jsenzel1/petrock/(threads)

Thread 2 (2024-06-07):

Update manual to make it clearer that under the New Moon B side does not output anything

nlighteneddesign, 2024-06-07:
I happened to first power on the PetRock under a new moon and it took a fair amount of confusion on why the B side would not output before I noticed the line in the manual:

```
New moon: A is emerging B is obscured
```

I first had read the Notes for use (technical) several times trying to figure out what was going wrong.
It may be helpful for future printings to include a note somewhere that explicitly states that the petrock does not output on B under the new moon.

nlighteneddesign, 2024-12-09:
PR was merged.

Closed 2024-12-09.

Thread 4 (2024-12-08):

Panel folder contains copy of mainboard files, not panel files

ryokell, 2024-12-08:
It looks like the panel folder just contains a copy of the same files as the board folder at the moment, not the panel files as expected.

jsenzel1, 2024-12-09:
hm, redownloaded and put em into kicad, looks like the panel files to me, maybe give it a once over and if its still not working I can just reupload?

ryokell, 2024-12-10:
ahh I see - apologies, the files all being named identically threw me off. It looks like they are indeed correct after all!

Closed 2024-12-10.
