jsenzel1/petrock/hardware - kiCad/board/input_protection.kicad_sch

## KiCad design hardware - kiCad/board/input_protection.kicad_sch (2023-12-20)

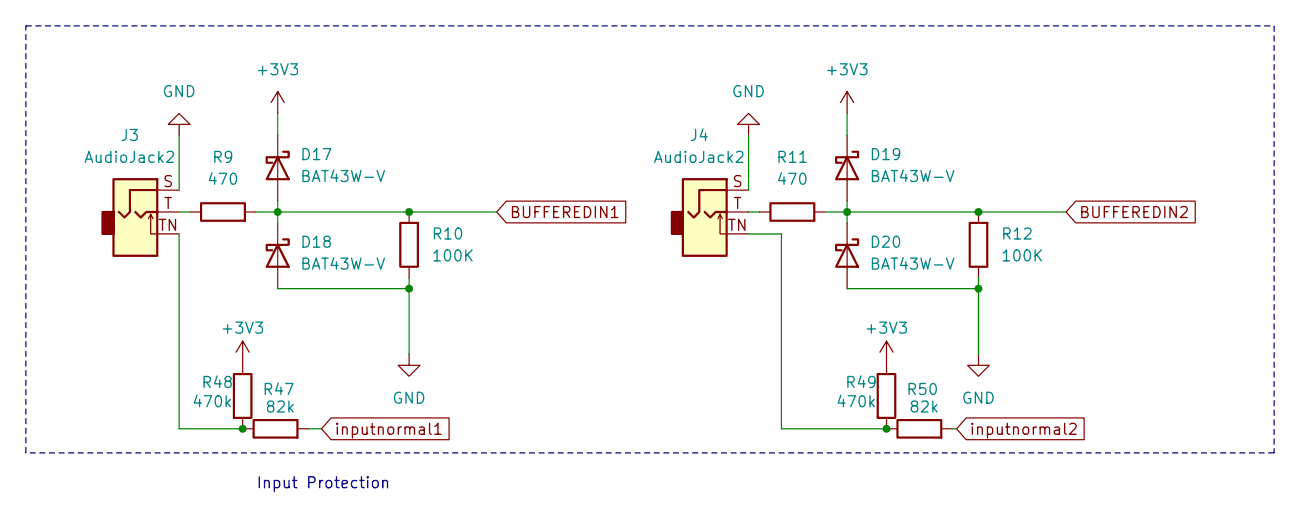
[picture p1: schematic input_protection.kicad_sch]

Parts:
D17, D18, D19, D20: BAT43W-V; D_SOD-323; JLC part Number C19167
J3, J4: AudioJack2; _Jack_3.5mm_QingPu_JACK_ANCHOR
R9, R11: 470; C_0402_1005Metric; JLC part Number C25117
R10, R12: 100K; C_0402_1005Metric; JLC part Number C25741
R47, R50: 82k; C_0402_1005Metric; LCSC C4142
R48, R49: 470k; C_0402_1005Metric; LCSC C25790

Connections:
+3V3: D17.1 (K), D19.1 (K), R48.1, R49.1
BUFFEREDIN1: D17.2 (A), D18.1 (K), R9.2, R10.2
BUFFEREDIN2: D19.2 (A), D20.1 (K), R11.2, R12.2
GND: D18.2 (A), D20.2 (A), J3.S, J4.S, R10.1, R12.1
unnamed: J3.T, R9.1
unnamed: J3.TN, R47.1, R48.2
unnamed: J4.T, R11.1
unnamed: J4.TN, R49.2, R50.1
inputnormal1: R47.2
inputnormal2: R50.2

Notes on the sheet:
Input Protection
