jsenzel1/petrock/hardware - kiCad/board/outPutLevelShift.kicad_sch

## KiCad design hardware - kiCad/board/outPutLevelShift.kicad_sch (2023-12-20)

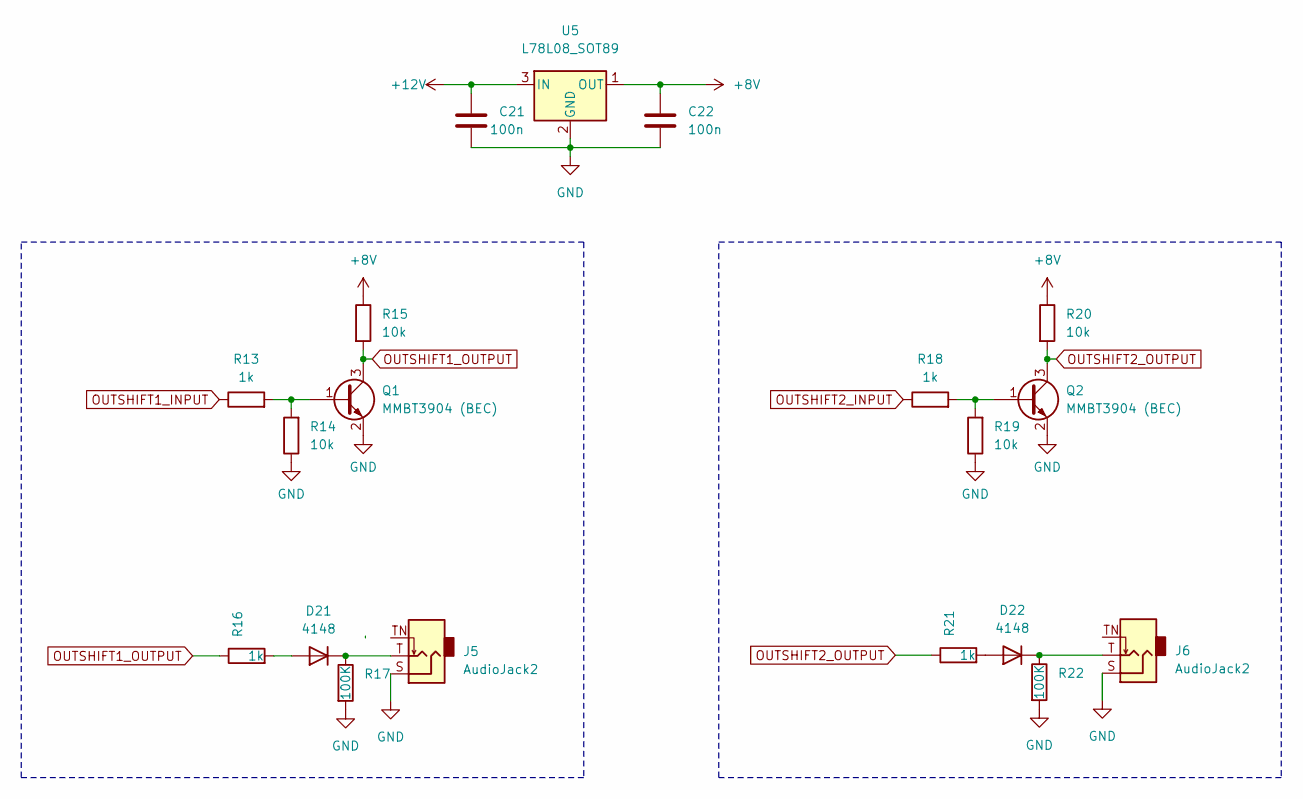
[picture p2: schematic outPutLevelShift.kicad_sch]

Parts:
C21, C22: 100n; C_0402_1005Metric; JLC part Number C1525
D21, D22: 4148; D_SOD-323; JLC part Number C81598
J5, J6: AudioJack2; _Jack_3.5mm_QingPu_JACK_ANCHOR
Q1, Q2: MMBT3904 (BEC); SOT-23; JLC part Number C20526
R13, R16, R18, R21: 1k; C_0402_1005Metric; LCSC C11702
R14, R15, R19, R20: 10k; C_0402_1005Metric; JLC part Number C25744
R17, R22: 100K; C_0402_1005Metric; JLC part Number C25741
U5: L78L08_SOT89; SOT-89-3; JLC part Number C122846

Connections:
+8V: C22.1, R15.1, R20.1, U5.1 (OUT)
+12V: C21.1, U5.3 (IN)
GND: C21.2, C22.2, J5.S, J6.S, Q1.2 (E), Q2.2 (E), R14.1, R17.2, R19.1, R22.2, U5.2 (GND)
unnamed: D21.1 (K), J5.T, R17.1
unnamed: D21.2 (A), R16.2
unnamed: D22.1 (K), J6.T, R22.1
unnamed: D22.2 (A), R21.2
unnamed: Q1.1 (B), R13.2, R14.2
unnamed: Q2.1 (B), R18.2, R19.2
OUTSHIFT1_INPUT: R13.1
OUTSHIFT1_OUTPUT: Q1.3 (C), R15.2, R16.1
OUTSHIFT2_INPUT: R18.1
OUTSHIFT2_OUTPUT: Q2.3 (C), R20.2, R21.1
