jsenzel1/petrock/hardware - kiCad/board/petRockMain1.kicad_sch

## KiCad design hardware - kiCad/board/petRockMain1.kicad_sch (2023-12-20)

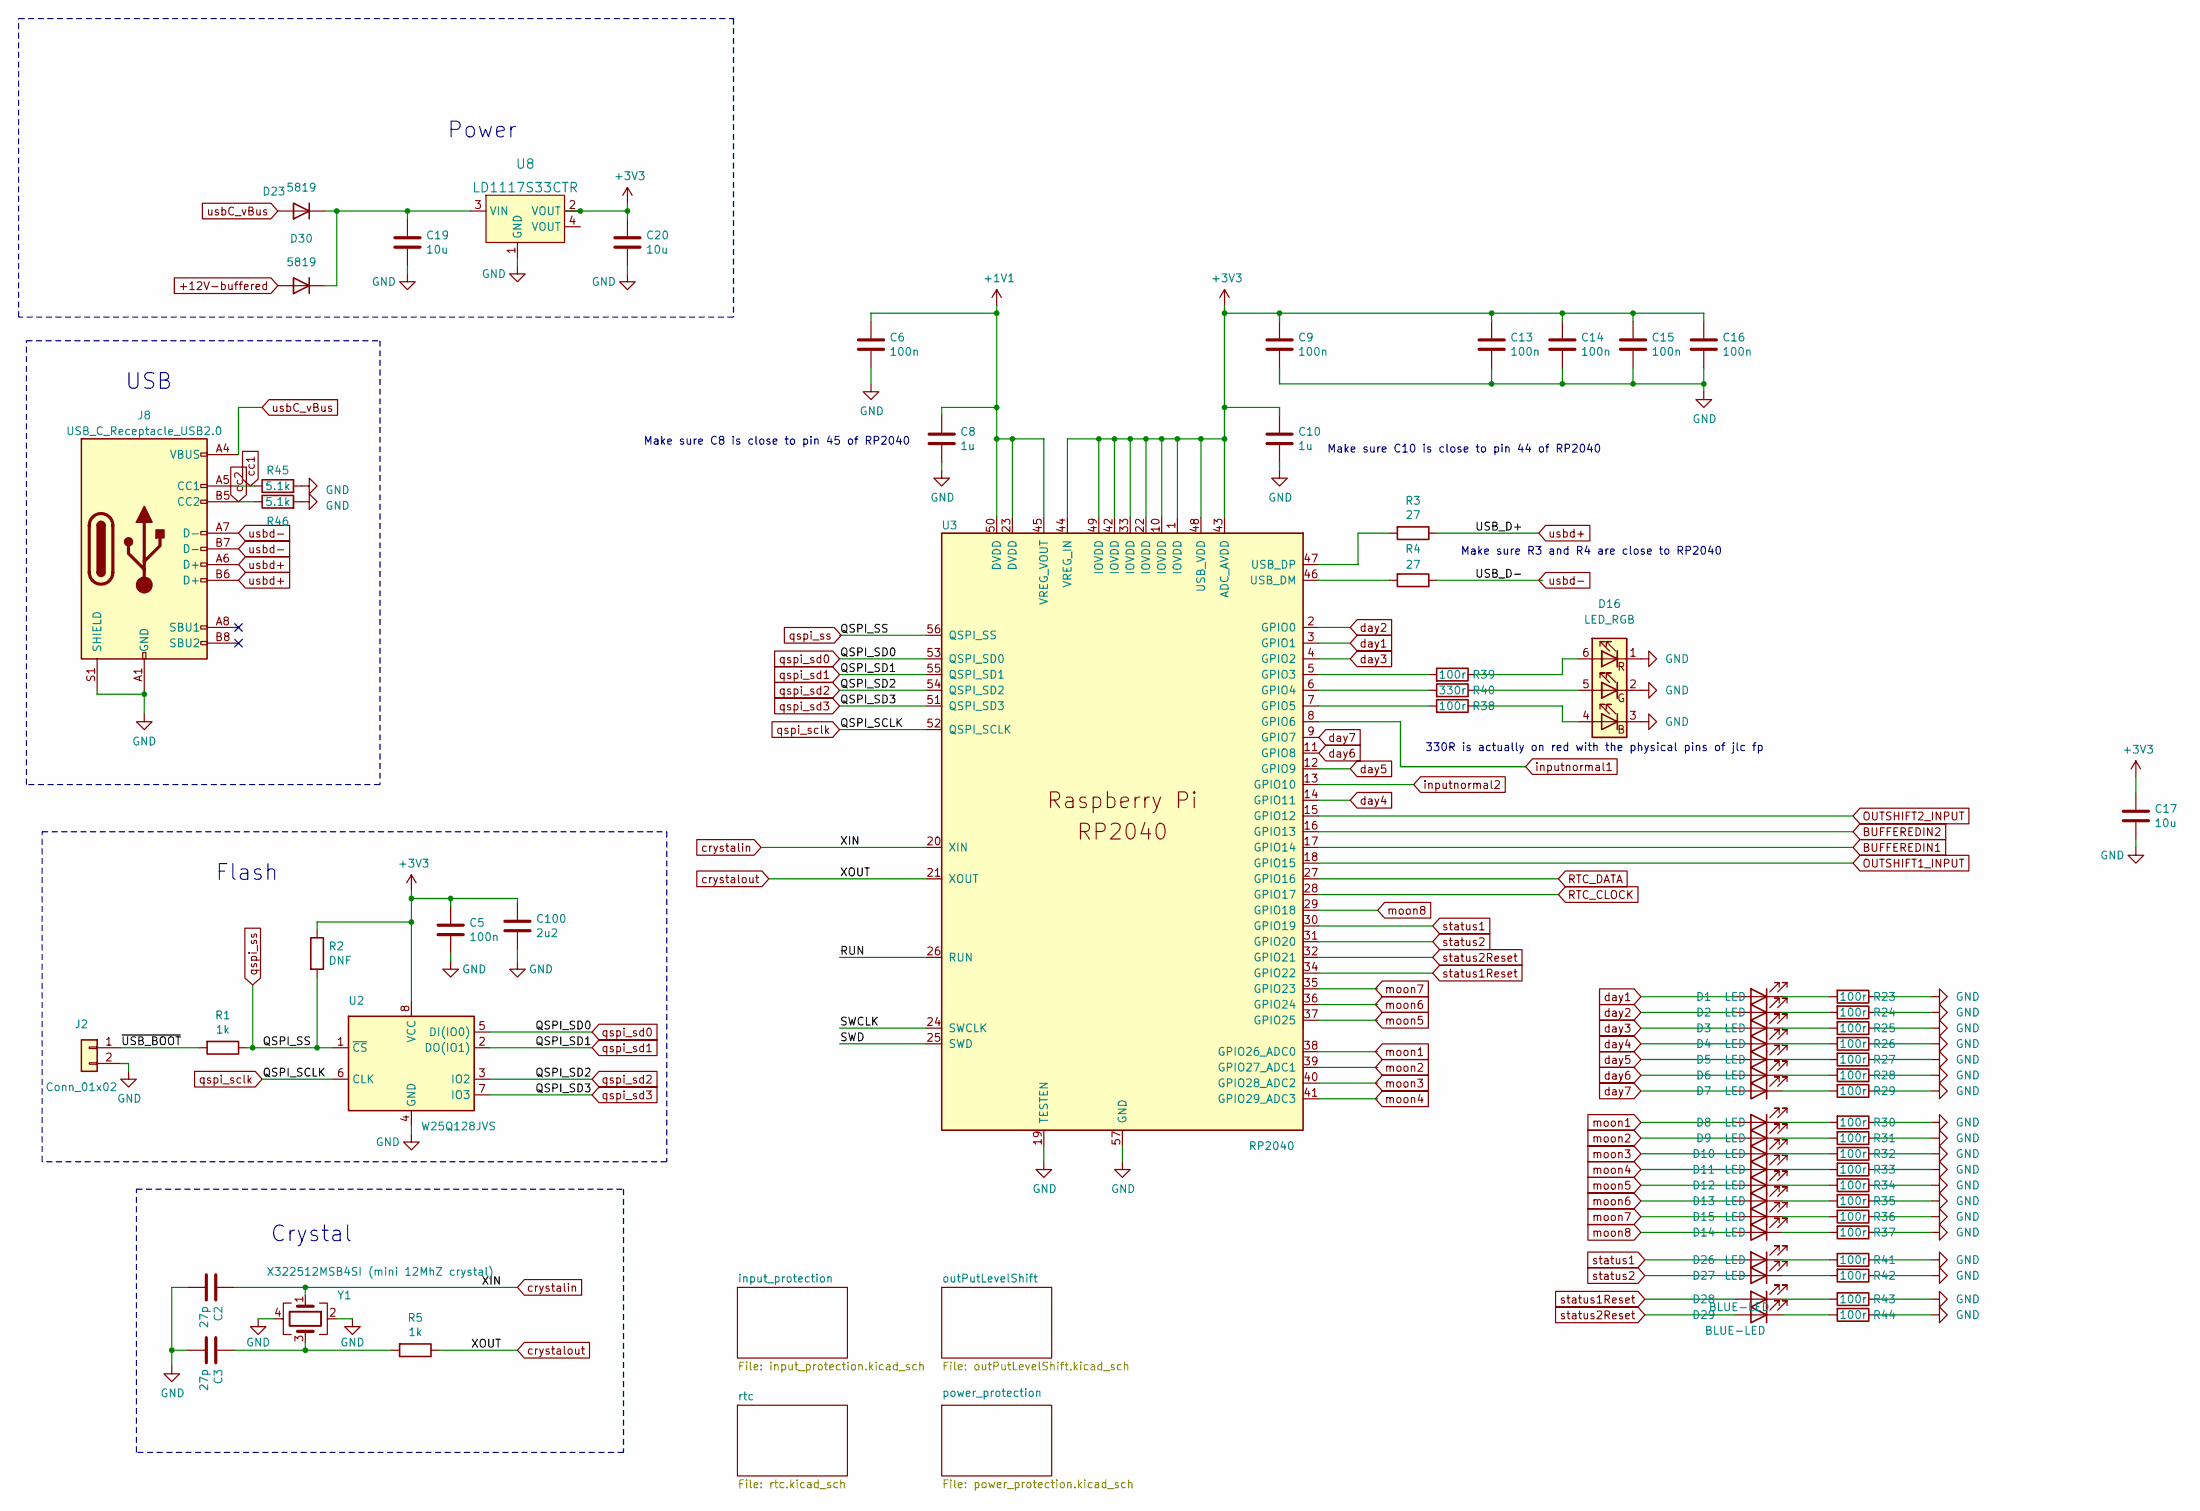
[picture p3: schematic petRockMain1.kicad_sch]

Parts:
C2, C3: 27p; C_0402_1005Metric; JLC part Number C1557
C5, C6, C9, C13, C14, C15, C16: 100n; C_0402_1005Metric; JLC part Number C1525
C8, C10: 1u; C_0402_1005Metric; JLC part Number C52923
C17, C19, C20: 10u; C_0402_1005Metric; JLC part Number C15850
C100: 2u2; C_0402_1005Metric; JLC part Number C1525
D1, D2, D3, D4, D5, D6, D7, D8, D9, D10, D11, D12, D13, D14, D15, D26, D27: LED; LED_0402_1005Metric; JLC part Number C72038
D16: LED_RGB; LED_RGB_5050-6; JLC part Number C784540
D23, D30: 5819; D_SOD-123; LCSC C8598
D28, D29: BLUE-LED; LED_0402_1005Metric; JLC part Number C72038
J2: Conn_01x02; SW_PUSH_6mm
J8: USB_C_Receptacle_USB2.0; USB_C_Receptacle_G-Switch_GT-USB-7010ASV; LCSC C2988369
R1, R5: 1k; C_0402_1005Metric; LCSC C11702
R2: DNF; C_0402_1005Metric
R3, R4: 27; C_0402_1005Metric; JLC part Number C25100
R23, R24, R25, R26, R27, R28, R29, R30, R31, R32, R33, R34, R35, R36, R37, R38, R39, R41, R42, R43, R44: 100r; C_0402_1005Metric; JLC part Number C25076
R40: 330r; C_0402_1005Metric; JLC part Number C25104
R45, R46: 5.1k; C_0402_1005Metric; LCSC C25905
U2: W25Q128JVS; SON50P300X200X60-9N; JLC part Number C97521
U3: RP2040; RP2040-QFN-56; JLC part Number C2040
U8: LD1117S33CTR; SOT-89-3; MPN LD1117S33CTR; Digi-Key_PN 497-1241-1-ND
Y1: X322512MSB4SI (mini 12MhZ crystal); Crystal_SMD_3225-4Pin_3.2x2.5mm; JLC part Number C111117

Connections:
+1V1: C6.1, C8.1, U3.23 (DVDD), U3.45 (VREG_VOUT), U3.50 (DVDD)
+3V3: C5.1, C9.1, C10.1, C13.1, C14.1, C15.1, C16.1, C17.1, C20.1, C100.1, R2.1, U2.8 (VCC), U3.1 (IOVDD), U3.10 (IOVDD), U3.22 (IOVDD), U3.33 (IOVDD), U3.42 (IOVDD), U3.43 (ADC_AVDD), U3.44 (VREG_IN), U3.48 (USB_VDD), U3.49 (IOVDD), U8.2 (VOUT)
+12V-buffered: D30.2 (A)
BUFFEREDIN1: U3.17 (GPIO14)
BUFFEREDIN2: U3.16 (GPIO13)
GND: C2.2, C3.2, C5.2, C6.2, C8.2, C9.2, C10.2, C13.2, C14.2, C15.2, C16.2, C17.2, C19.2, C20.2, C100.2, D16.1 (RK), D16.2 (GK), D16.3 (BK), J2.2, J8.A1 (GND), J8.A12 (GND), J8.B1 (GND), J8.B12 (GND), J8.S1 (SHIELD), R23.1, R24.1, R25.1, R26.1, R27.1, R28.1, R29.1, R30.1, R31.1, R32.1, R33.1, R34.1, R35.1, R36.1, R37.1, R41.1, R42.1, R43.1, R44.1, R45.2, R46.2, U2.4 (GND), U3.19 (TESTEN), U3.57 (GND), U8.1 (GND), Y1.2, Y1.4
unnamed: C3.1, R5.2, Y1.3
unnamed: C19.1, D23.1 (K), D30.1 (K), U8.3 (VIN)
unnamed: D1.1 (K), R23.2
unnamed: D2.1 (K), R24.2
unnamed: D3.1 (K), R25.2
unnamed: D4.1 (K), R26.2
unnamed: D5.1 (K), R27.2
unnamed: D6.1 (K), R28.2
unnamed: D7.1 (K), R29.2
unnamed: D8.1 (K), R30.2
unnamed: D9.1 (K), R31.2
unnamed: D10.1 (K), R32.2
unnamed: D11.1 (K), R33.2
unnamed: D12.1 (K), R34.2
unnamed: D13.1 (K), R35.2
unnamed: D14.1 (K), R37.2
unnamed: D15.1 (K), R36.2
unnamed: D16.4 (BA), R38.1
unnamed: D16.5 (GA), R40.1
unnamed: D16.6 (RA), R39.1
unnamed: D26.1 (K), R41.2
unnamed: D27.1 (K), R42.2
unnamed: D28.1 (K), R43.2
unnamed: D29.1 (K), R44.2
unnamed: R3.2, U3.47 (USB_DP)
unnamed: R4.2, U3.46 (USB_DM)
unnamed: R38.2, U3.7 (GPIO5)
unnamed: R39.2, U3.5 (GPIO3)
unnamed: R40.2, U3.6 (GPIO4)
OUTSHIFT1_INPUT: U3.18 (GPIO15)
OUTSHIFT2_INPUT: U3.15 (GPIO12)
RTC_CLOCK: U3.28 (GPIO17)
RTC_DATA: U3.27 (GPIO16)
RUN: U3.26 (RUN)
SWCLK: U3.24 (SWCLK)
SWD: U3.25 (SWD)
cc1: J8.A5 (CC1), R45.1
cc2: J8.B5 (CC2), R46.1
crystalin: C2.1, U3.20 (XIN), Y1.1
crystalout: R5.1, U3.21 (XOUT)
day1: D1.2 (A), U3.3 (GPIO1)
day2: D2.2 (A), U3.2 (GPIO0)
day3: D3.2 (A), U3.4 (GPIO2)
day4: D4.2 (A), U3.14 (GPIO11)
day5: D5.2 (A), U3.12 (GPIO9)
day6: D6.2 (A), U3.11 (GPIO8)
day7: D7.2 (A), U3.9 (GPIO7)
inputnormal1: U3.8 (GPIO6)
inputnormal2: U3.13 (GPIO10)
moon1: D8.2 (A), U3.38 (GPIO26_ADC0)
moon2: D9.2 (A), U3.39 (GPIO27_ADC1)
moon3: D10.2 (A), U3.40 (GPIO28_ADC2)
moon4: D11.2 (A), U3.41 (GPIO29_ADC3)
moon5: D12.2 (A), U3.37 (GPIO25)
moon6: D13.2 (A), U3.36 (GPIO24)
moon7: D15.2 (A), U3.35 (GPIO23)
moon8: D14.2 (A), U3.29 (GPIO18)
qspi_sclk: U2.6 (CLK), U3.52 (QSPI_SCLK)
qspi_sd0: U2.5 (DI(IO0)), U3.53 (QSPI_SD0)
qspi_sd1: U2.2 (DO(IO1)), U3.55 (QSPI_SD1)
qspi_sd2: U2.3 (IO2), U3.54 (QSPI_SD2)
qspi_sd3: U2.7 (IO3), U3.51 (QSPI_SD3)
qspi_ss: R1.1, R2.2, U2.1 (~CS), U3.56 (QSPI_SS)
status1: D26.2 (A), U3.30 (GPIO19)
status1Reset: D28.2 (A), U3.34 (GPIO22)
status2: D27.2 (A), U3.31 (GPIO20)
status2Reset: D29.2 (A), U3.32 (GPIO21)
usbC_vBus: D23.2 (A), J8.A4 (VBUS), J8.A9 (VBUS), J8.B4 (VBUS), J8.B9 (VBUS)
usbd+: J8.A6 (D+), J8.B6 (D+), R3.1
usbd-: J8.A7 (D-), J8.B7 (D-), R4.1
~USB_BOOT: J2.1, R1.2

Notes on the sheet:
Power
Flash
USB
Crystal
Make sure R3 and R4 are close to RP2040
Make sure C8 is close to pin 45 of RP2040
330R is actually on red with the physical pins of jlc fp
Make sure C10 is close to pin 44 of RP2040
