jsenzel1/petrock/hardware - kiCad/board/power_protection.kicad_sch

## KiCad design hardware - kiCad/board/power_protection.kicad_sch (2023-12-20)

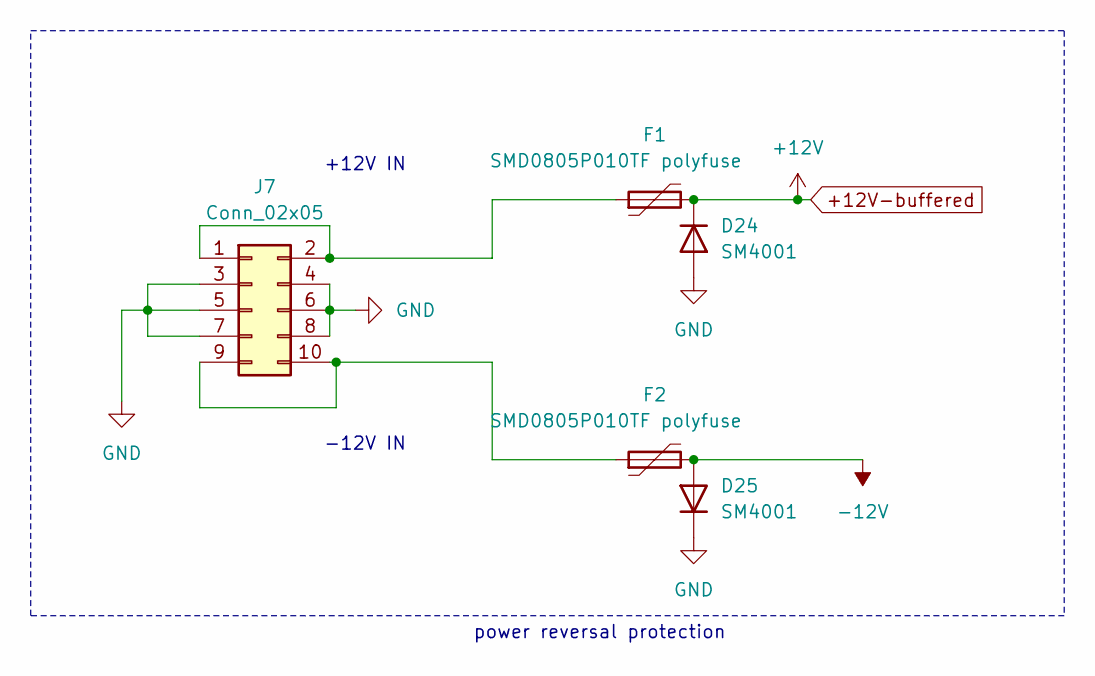
[picture p4: schematic power_protection.kicad_sch]

Parts:
D24, D25: SM4001; D_SOD-123; JLC part Number C151781
F1, F2: SMD0805P010TF polyfuse; Fuse_0805_2012Metric; JLC part Number C269104
J7: Conn_02x05; PinHeader_2x05_P2.54mm_Vertical

Connections:
+12V: D24.1 (K), F1.2
-12V: D25.2 (A), F2.2
GND: D24.2 (A), D25.1 (K), J7.3, J7.4, J7.5, J7.6, J7.7, J7.8
unnamed: F1.1, J7.1, J7.2
unnamed: F2.1, J7.9, J7.10

Notes on the sheet:
power reversal protection
+12V IN
-12V IN
