jsenzel1/petrock/hardware - kiCad/board/rtc.kicad_sch

## KiCad design hardware - kiCad/board/rtc.kicad_sch (2023-12-20)

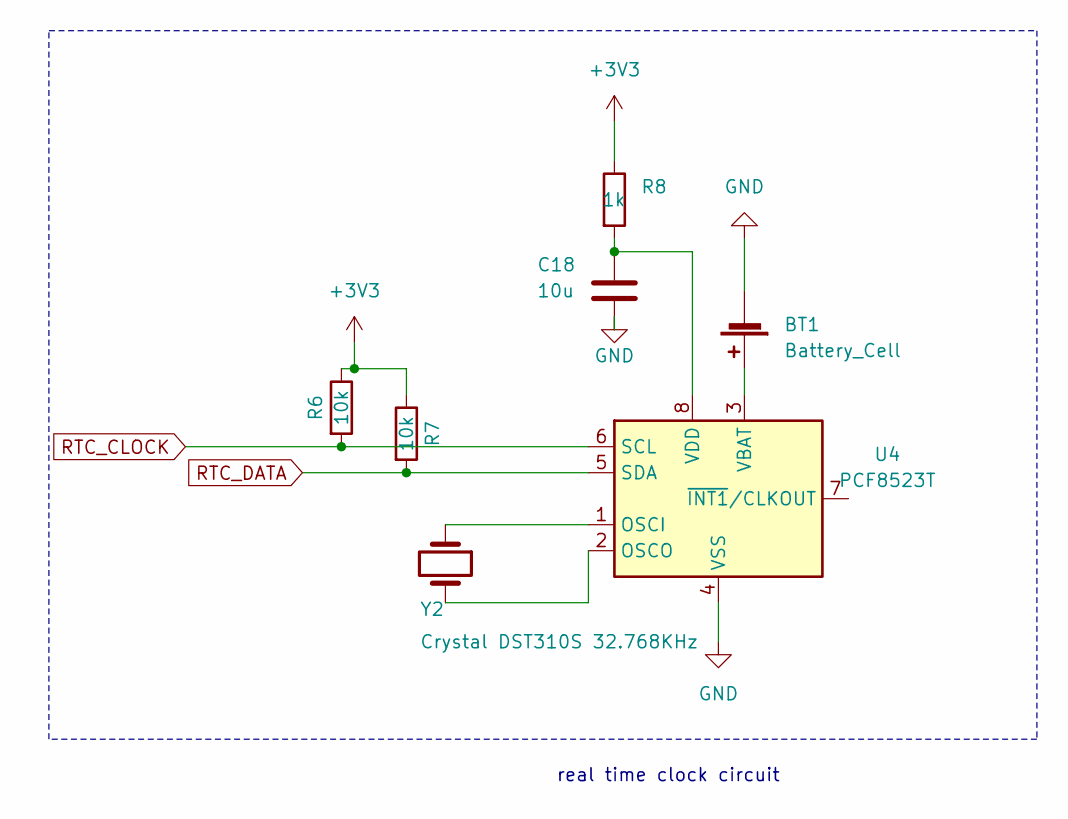
[picture p5: schematic rtc.kicad_sch]

Parts:
BT1: Battery_Cell; BatteryHolder_Keystone_3000_1x12mm; JLC part Number C964818
C18: 10u; C_0402_1005Metric; JLC part Number C15850
R6, R7: 10k; C_0402_1005Metric; JLC part Number C25744
R8: 1k; C_0402_1005Metric; LCSC C11702
U4: PCF8523T; SOIC-8_3.9x4.9mm_P1.27mm; JLC part Number C2651516
Y2: Crystal DST310S 32.768KHz; Crystal_SMD_3215-2Pin_3.2x1.5mm; JLC part Number C93232

Connections:
+3V3: R6.1, R7.1, R8.1
GND: BT1.2 (-), C18.2, U4.4 (VSS)
unnamed: BT1.1 (+), U4.3 (VBAT)
unnamed: C18.1, R8.2, U4.8 (VDD)
unnamed: U4.1 (OSCI), Y2.1
unnamed: U4.2 (OSCO), Y2.2
RTC_CLOCK: R6.2, U4.6 (SCL)
RTC_DATA: R7.2, U4.5 (SDA)

Notes on the sheet:
real time clock circuit
