jsenzel1/petrock/hardware - kiCad/panel/input_protection.kicad_sch

## KiCad design hardware - kiCad/panel/input_protection.kicad_sch (2024-10-06)

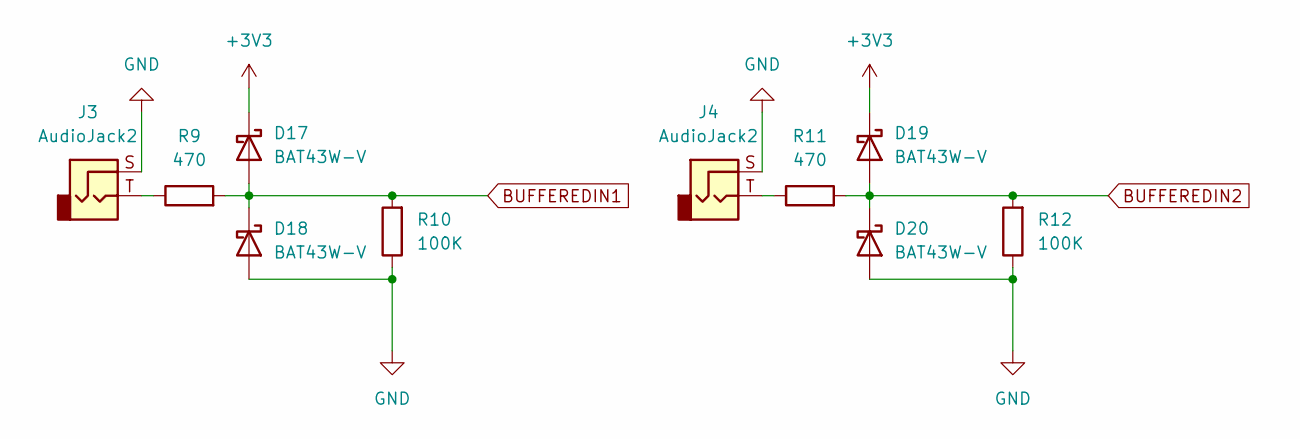
[picture p6: schematic input_protection.kicad_sch]

Parts:
D17, D18, D19, D20: BAT43W-V; D_SOD-123; JLC part Number C19167
J3, J4: AudioJack2; Jack_3.5mm_QingPu_WQP-PJ398SM_Vertical_CircularHoles
R9, R11: 470; C_0402_1005Metric; JLC part Number C25117
R10, R12: 100K; C_0402_1005Metric; JLC part Number C25741

Connections:
+3V3: D17.1 (K), D19.1 (K)
BUFFEREDIN1: D17.2 (A), D18.1 (K), R9.2, R10.2
BUFFEREDIN2: D19.2 (A), D20.1 (K), R11.2, R12.2
GND: D18.2 (A), D20.2 (A), J3.S, J4.S, R10.1, R12.1
unnamed: J3.T, R9.1
unnamed: J4.T, R11.1
