jsenzel1/petrock/software/firm-1.2/PhaseData.h

#include <stdio.h>
#include "pico/stdlib.h"

class PhaseData
{
    public:
    uint8_t phaseDataArray[36524] = {
1,
1,
2,
3,
3,
3,
3,
3,
3,
4,
5,
5,
5,
5,
5,
5,
6,
7,
7,
7,
7,
7,
7,
0,
1,
1,
1,
1,
1,
1,
1,
1,
2,
3,
3,
3,
3,
3,
3,
4,
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

};
