jsenzel1/petrock/software/firm-1.2/AlgoCulture.h

#include <stdio.h>
#include "pico/stdlib.h"
#include "jfunc.h" 
class AlgoCulture
{
	private:
		int seq[32]={0,0,0,0,0,0,0,0,0,0,0,0,0,0,0,0,0,0,0,0,0,0,0,0,0,0,0,0,0,0,0,0};
		int r1[32]={1,0,0,1,1,0,1,0,1,0,0,1,1,0,1,0,0,0,0,0,0,0,0,0,0,0,0,0,0,0,0,0};
		int r2[32]={1,0,0,1,0,0,1,0,0,0,1,0,1,0,0,0,0,0,0,0,0,0,0,0,0,0,0,0,0,0,0,0};
		int r3[32]={1,0,0,1,0,0,1,0,0,0,1,0,0,1,0,0,0,0,0,0,0,0,0,0,0,0,0,0,0,0,0,0};
		int r4[32]={1,0,1,0,1,0,1,0,1,0,0,1,1,0,1,0,0,0,0,0,0,0,0,0,0,0,0,0,0,0,0,0};
		int r5[32]={1,1,1,1,1,0,0,1,1,0,1,0,1,0,0,0,0,0,0,0,0,0,0,0,0,0,0,0,0,0,0,0};
		int r6[32]={1,1,0,1,1,0,1,0,1,1,0,1,1,0,1,0,0,0,0,0,0,0,0,0,0,0,0,0,0,0,0,0};
		int r7[32]={1,0,0,1,0,0,1,0,0,0,1,1,0,0,0,1,0,0,0,0,0,0,0,0,0,0,0,0,0,0,0,0};
		int r8[32]={1,0,0,0,1,0,0,0,1,0,0,0,1,0,0,0,0,0,0,0,0,0,0,0,0,0,0,0,0,0,0,0};
		
		//int rhythms[8][32]={r1,r2,r3,r4,r5,r6,r7,r8};

		int whichRhythm;

		int seqMax=0;
		int seqInd=0;

		int extraSteps=0;

		bool played;
		int myWeekday;
		int cyclePos;
	public:
        int inPin;
		int outPin;
		void init(int,int, int, int);
		void tick();

		AlgoCulture();
		~AlgoCulture();
};
