jsenzel1/petrock/(commit log)

2023-12-20 init real commit - inirealmit? incomitreal, realcomintral
    [input_protection.kicad_sch, outPutLevelShift.kicad_sch, petRockMain1.kicad_sch, power_protection.kicad_sch, rtc.kicad_sch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]
2024-02-07 Add files via upload
    add schematic pdf!
2024-10-06 added panel kicad files
    [input_protection.kicad_sch, outPutLevelShift.kicad_sch, petRockMain1.csv, petRockMain1.kicad_pcb, petRockMain1.kicad_sch, power_protection.kicad_sch, rtc.kicad_sch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]
